kuriki-sasa/Yak40/README.md

# Yak40
Yak40 is an Alice-like Keyboard

## Dependent libraries
- CadQuery
  https://pypi.org/project/cadquery/
- CQ-Kit
  https://pypi.org/project/cqkit/
- NumPy
  https://pypi.org/project/numpy/
- SciPy
  https://pypi.org/project/scipy/
- pykle_serial
  https://github.com/hajimen/pykle_serial
