kuriki-sasa/Yak40/plate/plate-Edge_Cuts_no-mounting-holes.dxf

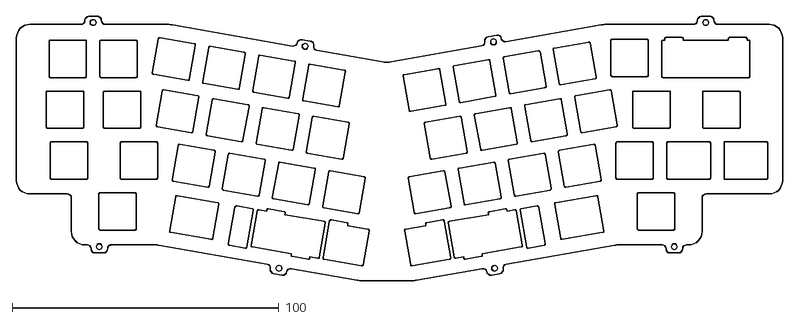
[picture p1: CAD file, 2024-02-02]
plate/plate-Edge_Cuts_no-mounting-holes.dxf
287.0 x 99.0
