kuriki-sasa/Yak40/case/production/bottom_plate.step

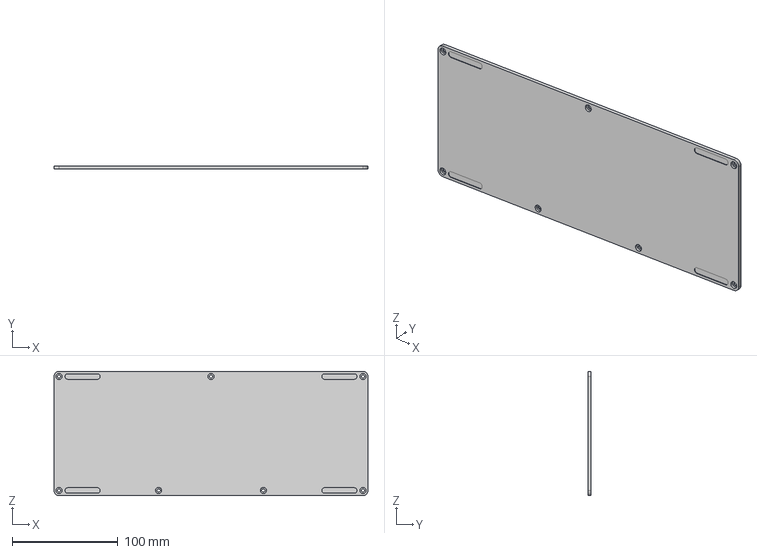
[picture p2: CAD file, 2025-01-12]
case/production/bottom_plate.step
297.6 x 3.00 x 117.7 mm
