kuriki-sasa/Yak40/plate/plate-Edge_Cuts.dxf

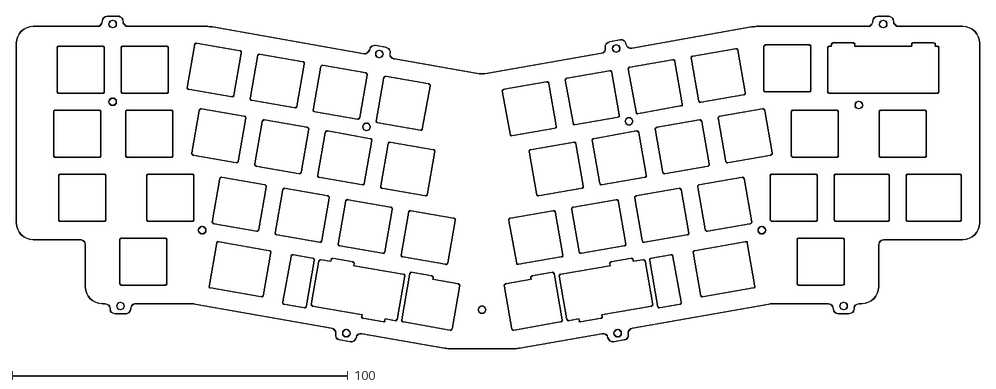
[picture p3: CAD file, 2024-02-02]
plate/plate-Edge_Cuts.dxf
287.0 x 99.0
