kuriki-sasa/Yak40/case/production/case.step

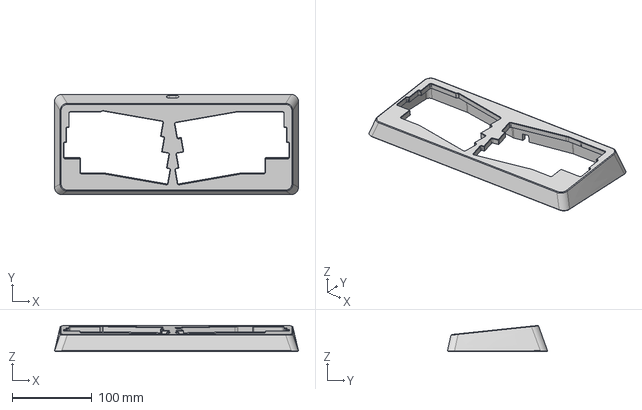
[picture p4: CAD file, 2024-02-06]
case/production/case.step
305.5 x 125.4 x 32.6 mm
