kuriki-sasa/Yak40/case/production/base_plate_7_holes.dxf

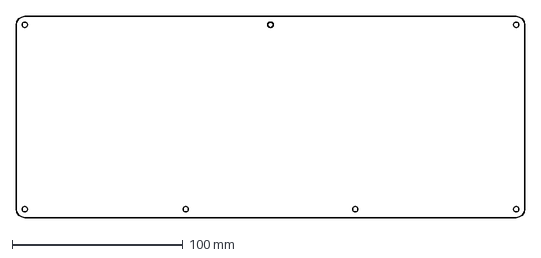
[picture p5: CAD file, 2024-02-02]
case/production/base_plate_7_holes.dxf
298.0 x 118.0 mm
