kuriki-sasa/Yak40/case/production/base_plate_4_holes.dxf

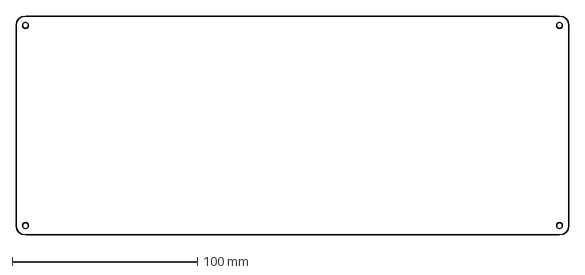
[picture p6: CAD file, 2024-02-02]
case/production/base_plate_4_holes.dxf
298.0 x 118.0 mm
