kuriki-sasa/Yak40/(list of files, cad)

Other CAD files:
case/production/laser_marking_drawing.dwg
case/production/case_chamfered.step
