kuriki-sasa/Yak40/docs/images/install_keycaps.jpg

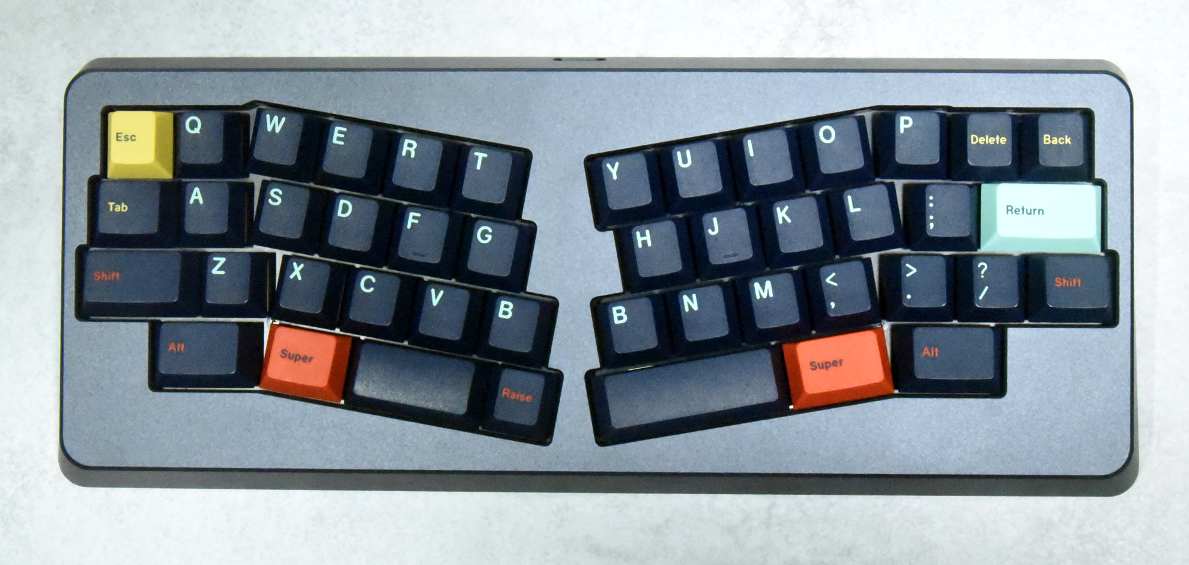
docs/images/install_keycaps.jpg
