kuriki-sasa/Yak40/case/production/logo_position.pdf

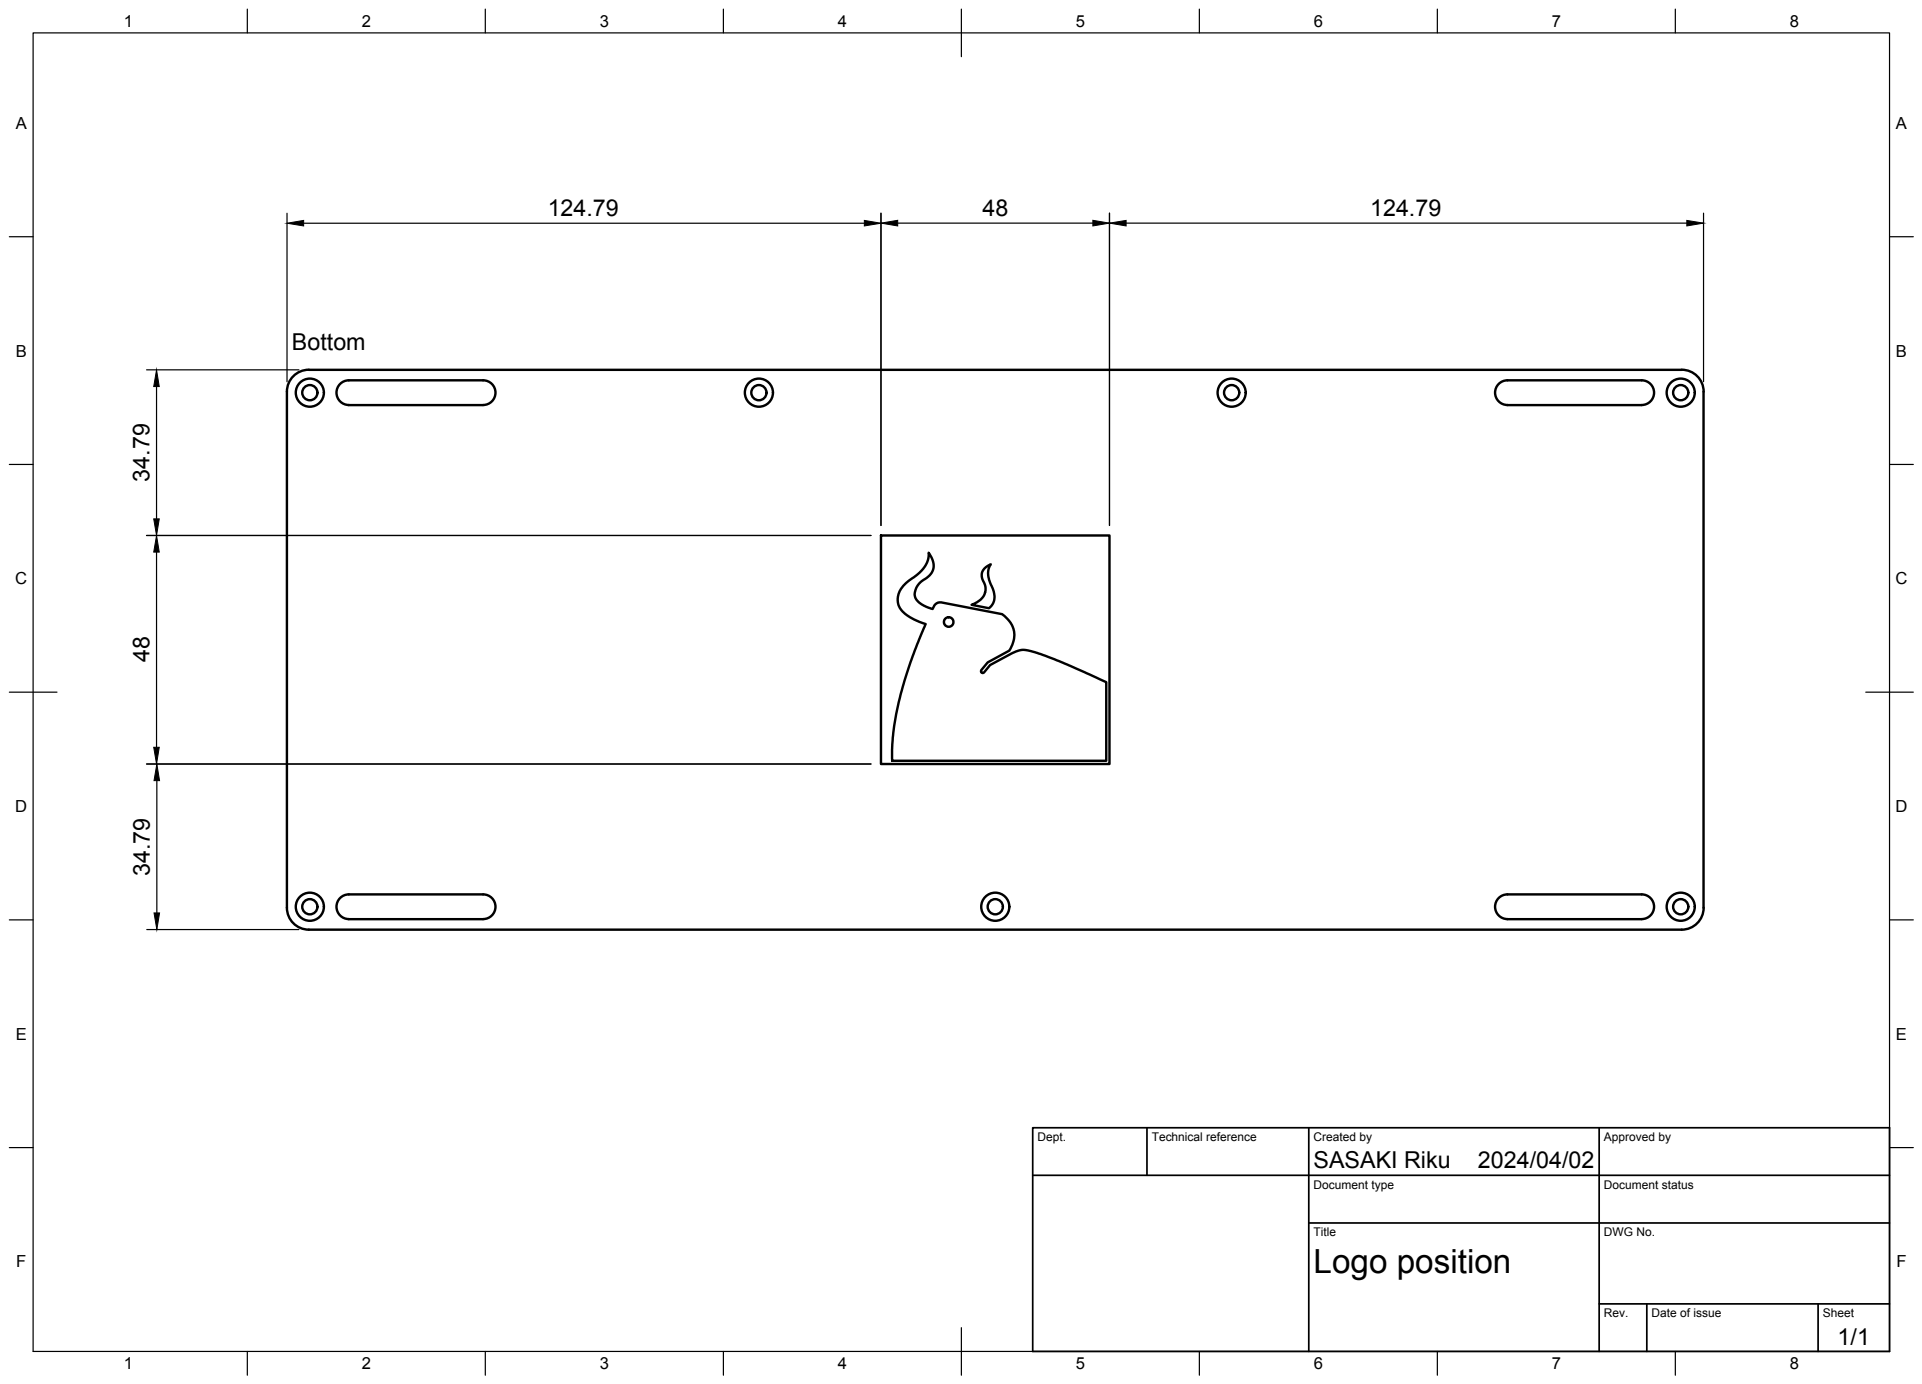
[picture p32: page 1]
Title; DWG No.; Rev.; Date of issue; Sheet; Logo position

Dept. | Technical reference | Created by SASAKI Riku 2024/04/02 | Approved by

Document type | Document status
