kuriki-sasa/Yak40/case/production/yak40_drawing.pdf

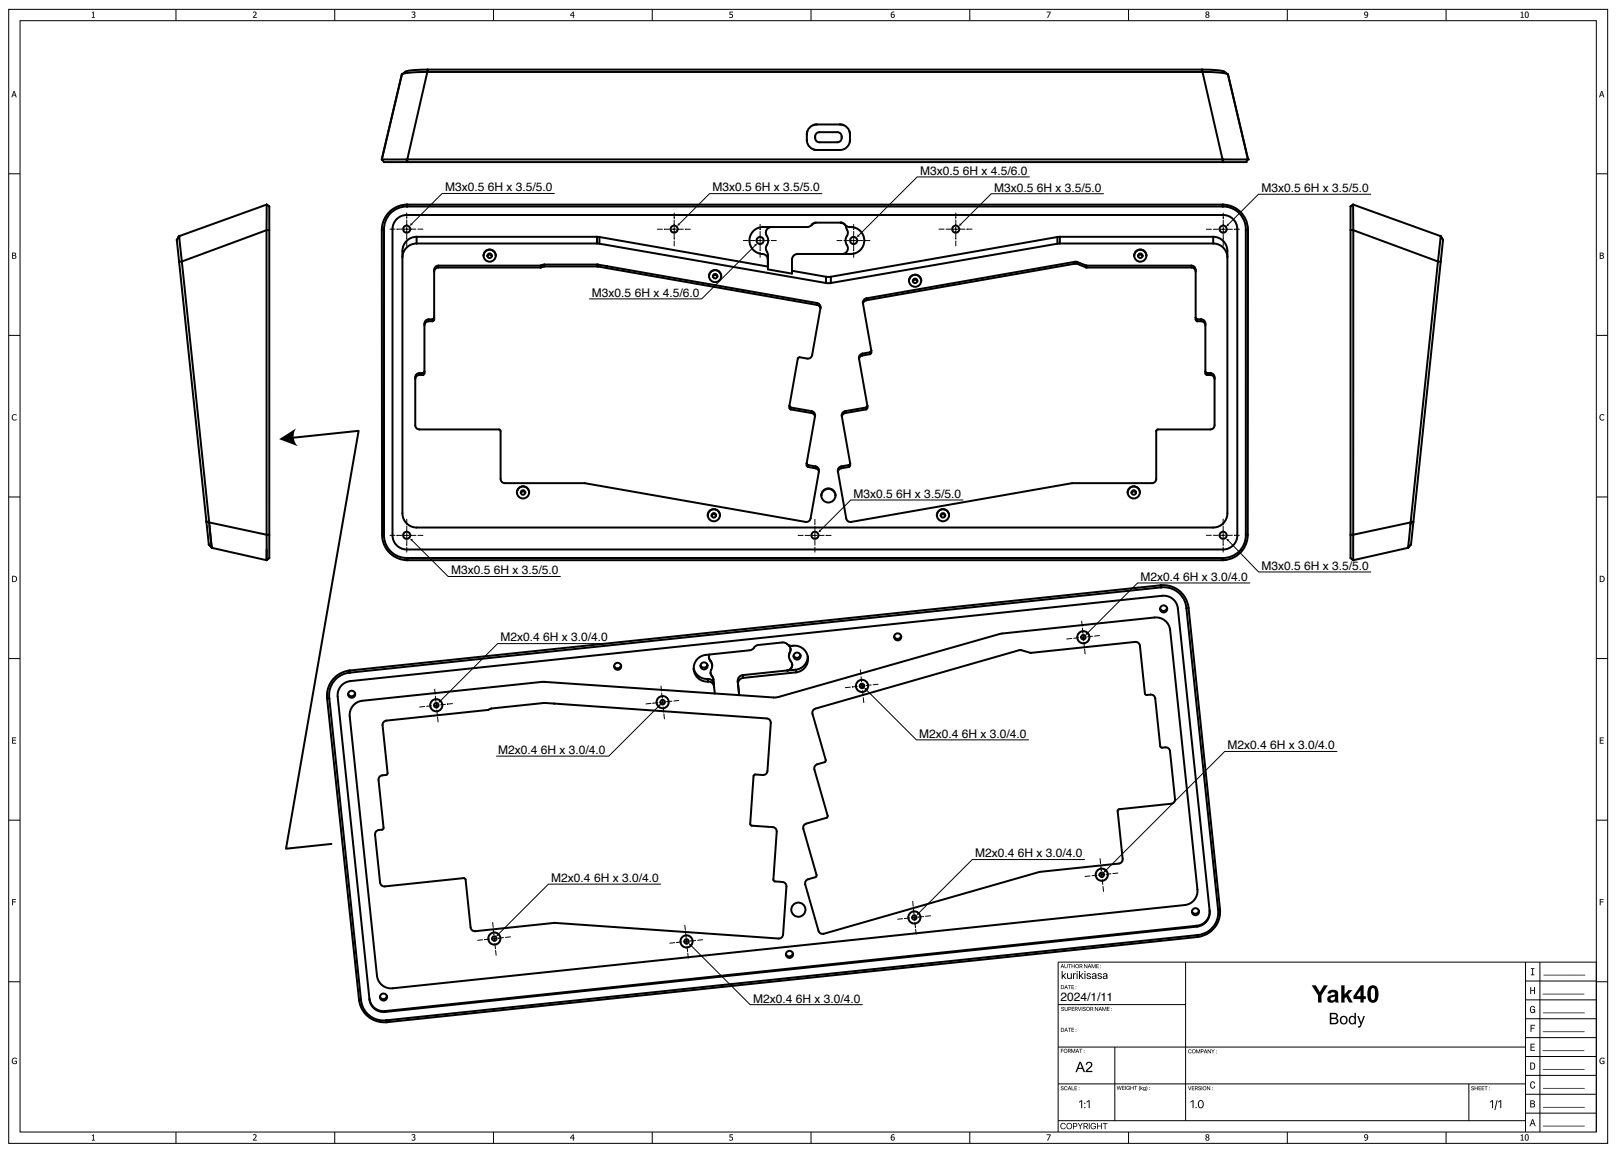
[picture p33: page 1]
