kuriki-sasa/Yak40/pcb/yak40_main/yak40_main.kicad_pcb

## KiCad design pcb/yak40_main/yak40_main.kicad_pcb (2024-06-22)

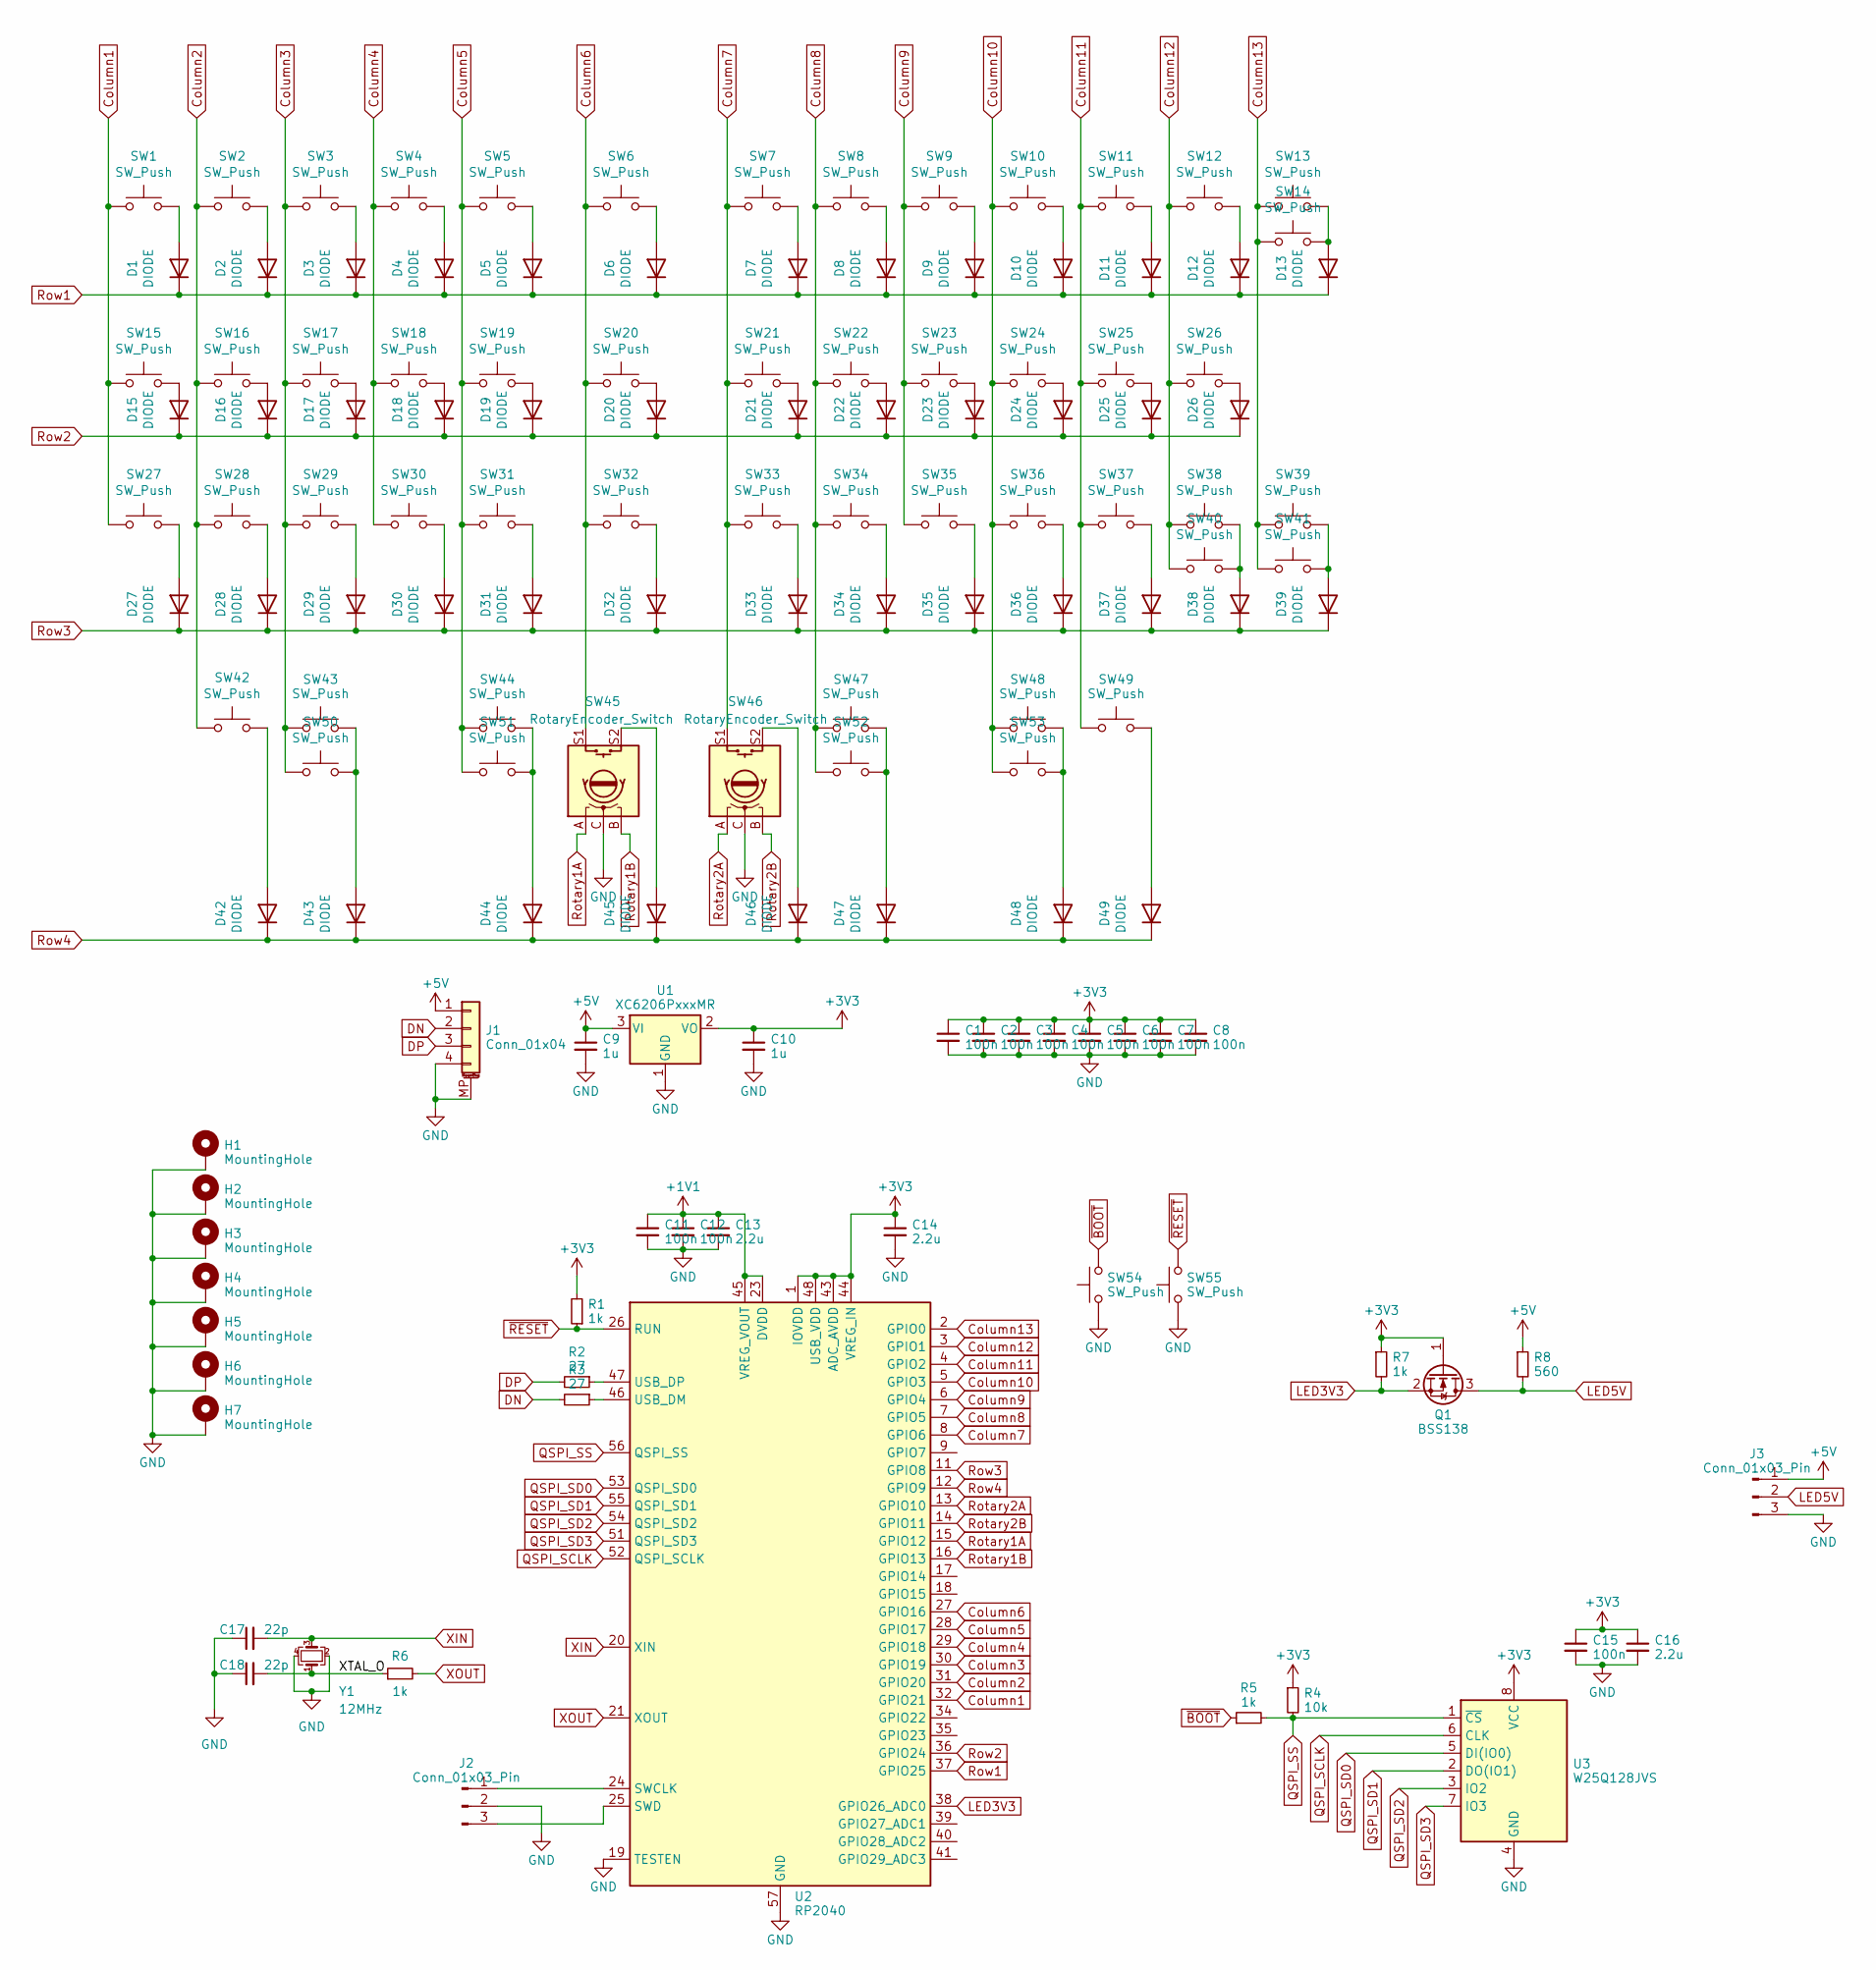
[picture p34: schematic yak40_main.kicad_sch]

Parts:
C1, C2, C3, C4, C5, C6, C7, C8, C11, C12, C15: 100n; C_0402_1005Metric
C9, C10: 1u; C_0402_1005Metric
C13, C14, C16: 2.2u; C_0402_1005Metric
C17, C18: 22p; C_0402_1005Metric; LCSC C1555
D1, D2, D3, D4, D5, D6, D7, D8, D9, D10, D11, D12, D13, D15, D16, D17, D18, D19, D20, D21, D22, D23, D24, D25, D26, D27, D28, D29, D30, D31, D32, D33, D34, D35, D36, D37, D38, D39, D42, D43, D44, D45, D46, D47, D48, D49: DIODE; D_SOD-123
H1, H2, H3, H4, H5, H6, H7: MountingHole; MountingHole_2.2mm_M2_ISO7380_Pad
J1: Conn_01x04; Molex_Pico-EZmate_78171-0004_1x04-1MP_P1.20mm_Vertical
J2, J3: Conn_01x03_Pin; PinHeader_1x03_P2.54mm_Vertical
Q1: BSS138; SOT-23
R1, R5, R7: 1k; R_0402_1005Metric
R2, R3: 27; R_0402_1005Metric
R4: 10k; R_0402_1005Metric
R6: 1k; R_0402_1005Metric; LCSC C11702
R8: 560; R_0603_1608Metric
SW1, SW2, SW3, SW4, SW5, SW6, SW7, SW8, SW9, SW10, SW11, SW12, SW13, SW16, SW17, SW18, SW19, SW20, SW21, SW22, SW23, SW24, SW25, SW28, SW29, SW30, SW31, SW32, SW33, SW34, SW35, SW36, SW37, SW39, SW40: SW_Push; MX-Hotswap-1U
SW14, SW44, SW47: SW_Push; MX-Hotswap-2U
SW15, SW38, SW41, SW43, SW48: SW_Push; MX-Hotswap-1.25U
SW26, SW27: SW_Push; MX-Hotswap-1.75U
SW42, SW49, SW50, SW53: SW_Push; MX-Hotswap-1.5U
SW45, SW46: RotaryEncoder_Switch; SW_Cherry_MX_1.00u_Kailh_EC12
SW51, SW52: SW_Push; MX-Hotswap-2.75U
SW54, SW55: SW_Push; SW_Push_1P1T_XKB_TS-1187A
U1: XC6206PxxxMR; SOT-23-3
U2: RP2040; QFN-56-1EP_7x7mm_P0.4mm_EP3.2x3.2mm
U3: W25Q128JVS; SOIC-8_5.23x5.23mm_P1.27mm
Y1: 12MHz; Crystal_SMD_3225-4Pin_3.2x2.5mm; LCSC C9002

Connections:
+1V1: C11.1, C12.1, C13.1, U2.23 (DVDD), U2.45 (VREG_VOUT), U2.50 (DVDD)
+3V3: C1.1, C2.1, C3.1, C4.1, C5.1, C6.1, C7.1, C8.1, C10.1, C14.1, C15.1, C16.1, Q1.1 (G), R1.2, R4.1, R7.1, U1.2 (VO), U2.1 (IOVDD), U2.10 (IOVDD), U2.22 (IOVDD), U2.33 (IOVDD), U2.42 (IOVDD), U2.43 (ADC_AVDD), U2.44 (VREG_IN), U2.48 (USB_VDD), U2.49 (IOVDD), U3.8 (VCC)
+5V: C9.1, J1.1, J3.1, R8.1, U1.3 (VI)
/XTAL_O: C18.2, R6.1, Y1.1
Column1: SW1.1, SW15.1, SW27.1, U2.32 (GPIO21)
Column2: SW2.1, SW16.1, SW28.1, SW42.1, U2.31 (GPIO20)
Column3: SW3.1, SW17.1, SW29.1, SW43.1, SW50.1, U2.30 (GPIO19)
Column4: SW4.1, SW18.1, SW30.1, U2.29 (GPIO18)
Column5: SW5.1, SW19.1, SW31.1, SW44.1, SW51.1, U2.28 (GPIO17)
Column6: SW6.1, SW20.1, SW32.1, SW45.S1, U2.27 (GPIO16)
Column7: SW7.1, SW21.1, SW33.1, SW46.S1, U2.8 (GPIO6)
Column8: SW8.1, SW22.1, SW34.1, SW47.1, SW52.1, U2.7 (GPIO5)
Column9: SW9.1, SW23.1, SW35.1, U2.6 (GPIO4)
Column10: SW10.1, SW24.1, SW36.1, SW48.1, SW53.1, U2.5 (GPIO3)
Column11: SW11.1, SW25.1, SW37.1, SW49.1, U2.4 (GPIO2)
Column12: SW12.1, SW26.1, SW38.1, SW40.1, U2.3 (GPIO1)
Column13: SW13.1, SW14.1, SW39.1, SW41.1, U2.2 (GPIO0)
DN: J1.2, R3.2
DP: J1.3, R2.2
GND: C1.2, C2.2, C3.2, C4.2, C5.2, C6.2, C7.2, C8.2, C9.2, C10.2, C11.2, C12.2, C13.2, C14.2, C15.2, C16.2, C17.1, C18.1, H1.1, H2.1, H3.1, H4.1, H5.1, H6.1, H7.1, J1.4, J1.MP (MountPin), J2.2, J3.3, SW45.C, SW46.C, SW54.1, SW55.1, U1.1 (GND), U2.19 (TESTEN), U2.57 (GND), U3.4 (GND), Y1.2, Y1.4
LED3V3: Q1.2 (S), R7.2, U2.38 (GPIO26_ADC0)
LED5V: J3.2, Q1.3 (D), R8.2
unnamed: D1.2 (A), SW1.2
unnamed: D2.2 (A), SW2.2
unnamed: D3.2 (A), SW3.2
unnamed: D4.2 (A), SW4.2
unnamed: D5.2 (A), SW5.2
unnamed: D6.2 (A), SW6.2
unnamed: D7.2 (A), SW7.2
unnamed: D8.2 (A), SW8.2
unnamed: D9.2 (A), SW9.2
unnamed: D10.2 (A), SW10.2
unnamed: D11.2 (A), SW11.2
unnamed: D12.2 (A), SW12.2
unnamed: D13.2 (A), SW13.2, SW14.2
unnamed: D15.2 (A), SW15.2
unnamed: D16.2 (A), SW16.2
unnamed: D17.2 (A), SW17.2
unnamed: D18.2 (A), SW18.2
unnamed: D19.2 (A), SW19.2
unnamed: D20.2 (A), SW20.2
unnamed: D21.2 (A), SW21.2
unnamed: D22.2 (A), SW22.2
unnamed: D23.2 (A), SW23.2
unnamed: D24.2 (A), SW24.2
unnamed: D25.2 (A), SW25.2
unnamed: D26.2 (A), SW26.2
unnamed: D27.2 (A), SW27.2
unnamed: D28.2 (A), SW28.2
unnamed: D29.2 (A), SW29.2
unnamed: D30.2 (A), SW30.2
unnamed: D31.2 (A), SW31.2
unnamed: D32.2 (A), SW32.2
unnamed: D33.2 (A), SW33.2
unnamed: D34.2 (A), SW34.2
unnamed: D35.2 (A), SW35.2
unnamed: D36.2 (A), SW36.2
unnamed: D37.2 (A), SW37.2
unnamed: D38.2 (A), SW38.2, SW40.2
unnamed: D39.2 (A), SW39.2, SW41.2
unnamed: D42.2 (A), SW42.2
unnamed: D43.2 (A), SW43.2, SW50.2
unnamed: D44.2 (A), SW44.2, SW51.2
unnamed: D45.2 (A), SW45.S2
unnamed: D46.2 (A), SW46.S2
unnamed: D47.2 (A), SW47.2, SW52.2
unnamed: D48.2 (A), SW48.2, SW53.2
unnamed: D49.2 (A), SW49.2
unnamed: J2.1, U2.24 (SWCLK)
unnamed: J2.3, U2.25 (SWD)
unnamed: R3.1, U2.46 (USB_DM)
unnamed: R2.1, U2.47 (USB_DP)
QSPI_SCLK: U2.52 (QSPI_SCLK), U3.6 (CLK)
QSPI_SD0: U2.53 (QSPI_SD0), U3.5 (DI(IO0))
QSPI_SD1: U2.55 (QSPI_SD1), U3.2 (DO(IO1))
QSPI_SD2: U2.54 (QSPI_SD2), U3.3 (IO2)
QSPI_SD3: U2.51 (QSPI_SD3), U3.7 (IO3)
QSPI_SS: R4.2, R5.2, U2.56 (QSPI_SS), U3.1 (~CS)
Rotary1A: SW45.A, U2.15 (GPIO12)
Rotary1B: SW45.B, U2.16 (GPIO13)
Rotary2A: SW46.A, U2.13 (GPIO10)
Rotary2B: SW46.B, U2.14 (GPIO11)
Row1: D1.1 (K), D2.1 (K), D3.1 (K), D4.1 (K), D5.1 (K), D6.1 (K), D7.1 (K), D8.1 (K), D9.1 (K), D10.1 (K), D11.1 (K), D12.1 (K), D13.1 (K), U2.37 (GPIO25)
Row2: D15.1 (K), D16.1 (K), D17.1 (K), D18.1 (K), D19.1 (K), D20.1 (K), D21.1 (K), D22.1 (K), D23.1 (K), D24.1 (K), D25.1 (K), D26.1 (K), U2.36 (GPIO24)
Row3: D27.1 (K), D28.1 (K), D29.1 (K), D30.1 (K), D31.1 (K), D32.1 (K), D33.1 (K), D34.1 (K), D35.1 (K), D36.1 (K), D37.1 (K), D38.1 (K), D39.1 (K), U2.11 (GPIO8)
Row4: D42.1 (K), D43.1 (K), D44.1 (K), D45.1 (K), D46.1 (K), D47.1 (K), D48.1 (K), D49.1 (K), U2.12 (GPIO9)
XIN: C17.2, U2.20 (XIN), Y1.3
XOUT: R6.2, U2.21 (XOUT)
~BOOT: R5.1, SW54.2
~RESET: R1.1, SW55.2, U2.26 (RUN)

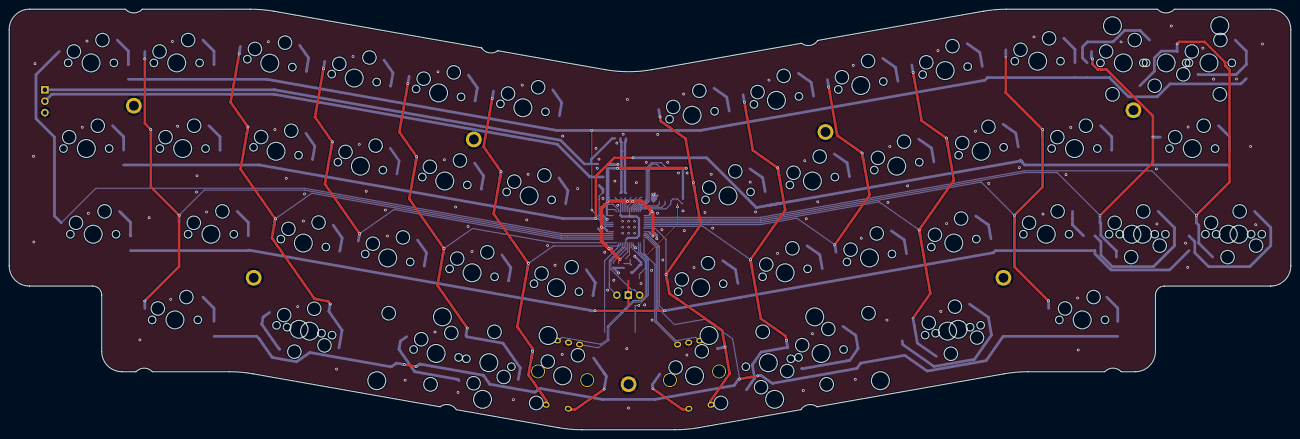
[picture p35: board yak40_main.kicad_pcb from above]

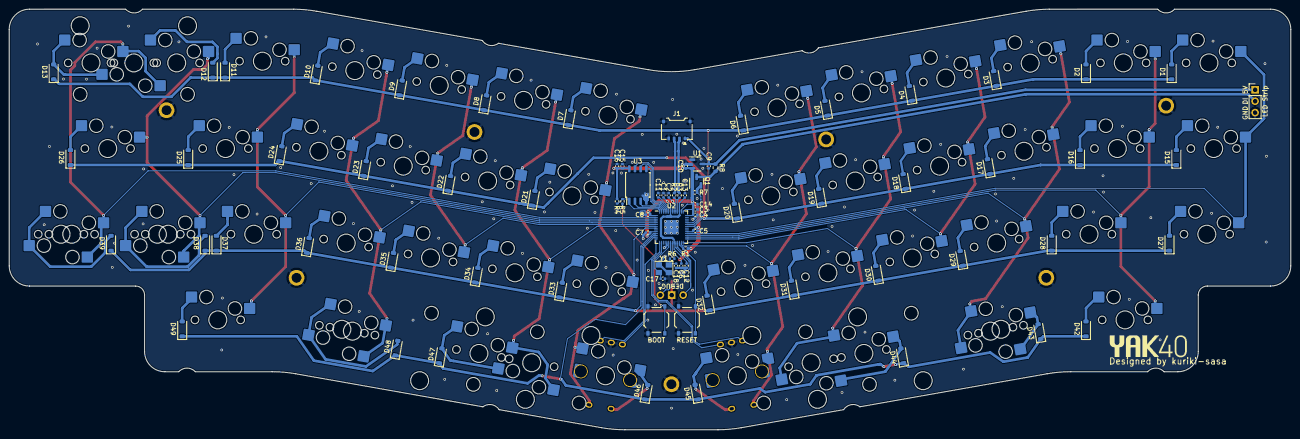
[picture p36: board yak40_main.kicad_pcb from below]

Board: 2 copper layers, 285.0 x 93.5 mm, 142 parts (82 on the bottom side), 90 nets.
