kuriki-sasa/Yak40/(commit log)

2023-09-24 Add submodule for key switch footprint
2023-09-24 Add main project
    [yak40_main.kicad_pcb, yak40_main.kicad_sch]
2023-10-21 Change footprint library for switch to MX_V2
2023-10-21 Add files for plate
    [fr4_plate.kicad_pcb, fr4_plate.kicad_sch, yak40_plate-Edge_Cuts.dxf]
2023-10-21 Wiring footprints
    [yak40_main.kicad_pcb, yak40_main.kicad_sch]
2023-11-23 [WIP]Add case files
    [case.step]
2023-11-29 Add screw holes
2023-11-29 Move STEP/STL files to build directory
    [case.step]
2023-11-29 Fix screw hole depth
    [case.step]
2023-12-01 Fix depth for o-ring
    [case.step]
2023-12-01 Add dxf files for base plate
    [base_plate_4_holes.dxf, base_plate_7_holes.dxf]
2024-01-03 Update case
    [base_plate_4_holes.dxf, base_plate_7_holes.dxf, case.step, case_chamfered.step]
2024-01-03 Update pcb
    [yak40_main.kicad_pcb, yak40_main.kicad_sch]
2024-01-03 Update plate
    [plate-Edge_Cuts.dxf, plate-Edge_Cuts_no-mounting-holes.dxf, yak40_plate-Edge_Cuts.dxf]
2024-02-02 Update PCB to be cheaper
    [BOM-yak40_main.csv, yak40_main.kicad_pcb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]
2024-02-02 Update plate files
    [plate-Edge_Cuts.dxf, plate-Edge_Cuts_no-mounting-holes.dxf]
2024-02-06 Update case files to released version
    [case.step]
2024-06-22 Support LED and rotary encoders
    [yak40_main.kicad_pcb, yak40_main.kicad_sch]
2024-11-10 Add description of PCB thickness
2025-01-12 Add bottom plate files for CNC milling
    [bottom_plate.step]
2025-01-12 Add drawing for laser marking
    [laser_marking_drawing.dwg]
